Caty129/BraillePrinter/README.md

# BraillePrinter - Beta (work in progress)
- This project is based on the project of iapafoto: https://github.com/iapafoto/BraillePrinter
- Instruction videos: https://www.instructables.com/id/Cheap-Braille-Embosser-La-Picoreuse/
- OpenScad: Laser cut design https://www.thingiverse.com/thing:2841496

## Variant Arduino Uno (poplar wood)
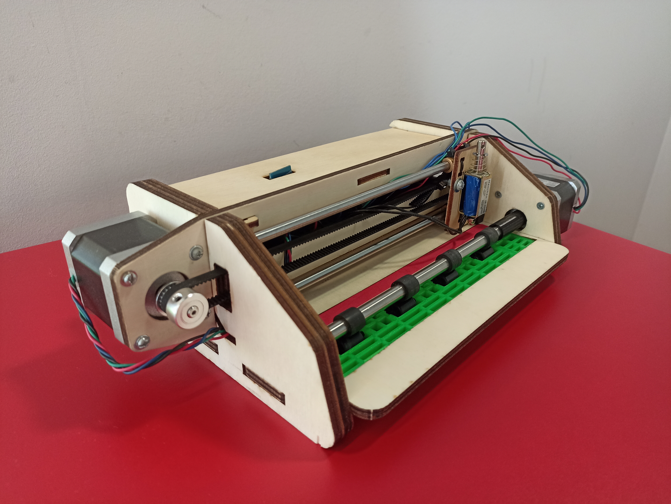
[picture p1: images/VarianteArduinoUno.jpg]


## Variant ESP32 (acrylic)
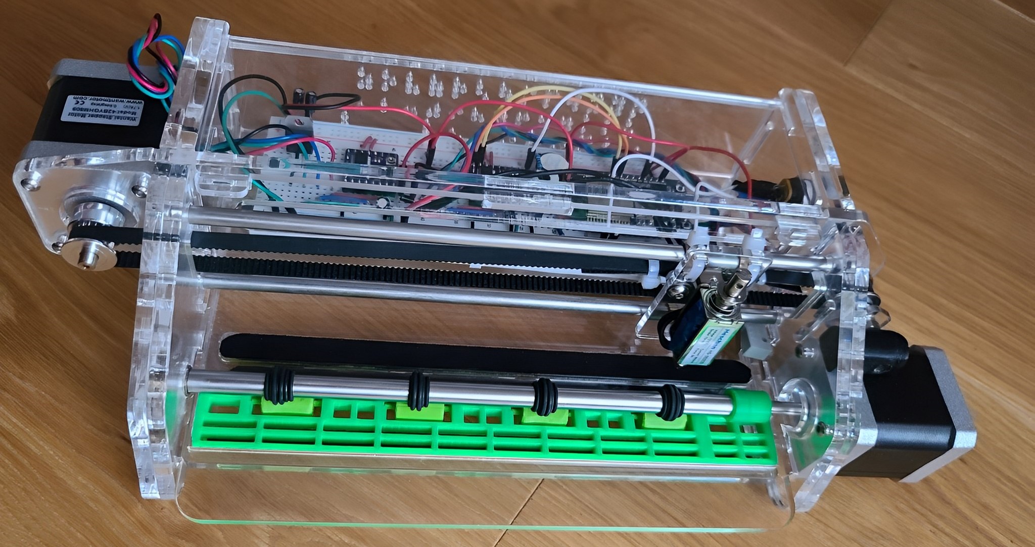
[picture p2: images/VarianteESP32.jpg]
