Caty129/BraillePrinter/Variante Arduino Uno/schematic.pdf

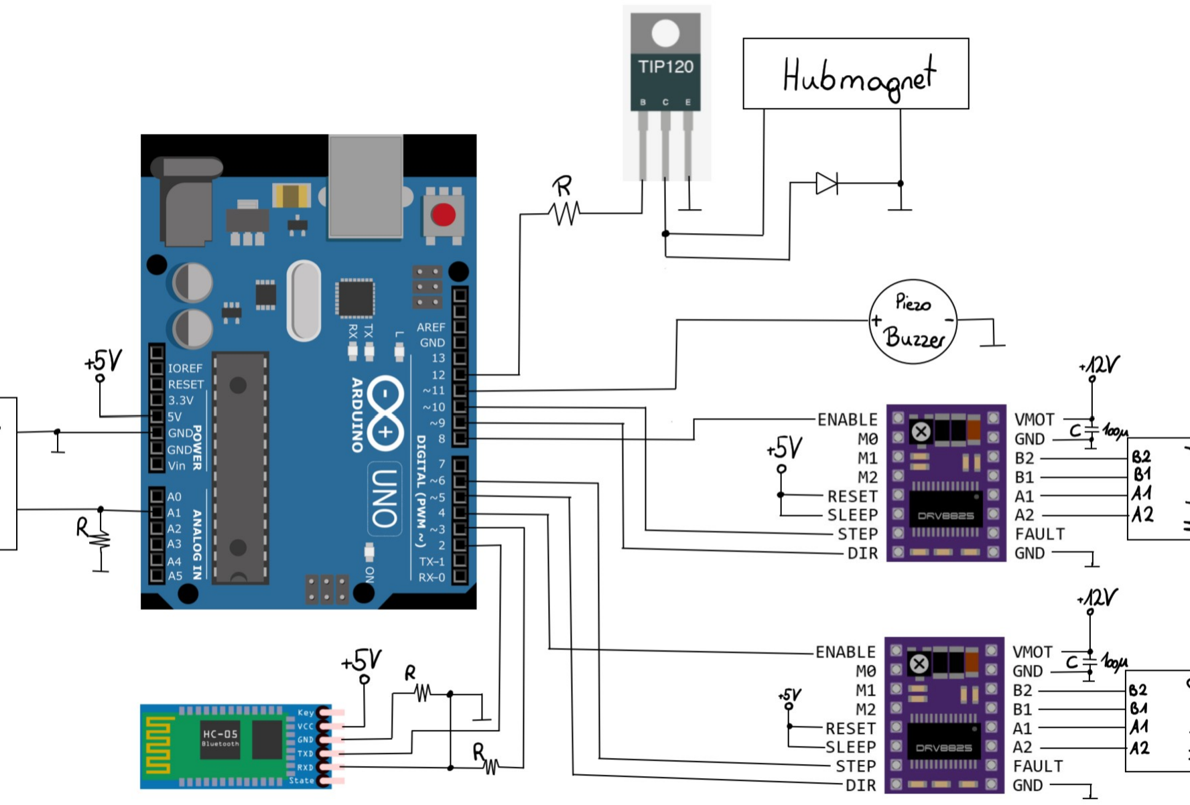
[picture p3: page 1]
