Caty129/BraillePrinter/Variante ESP32/schematic.png

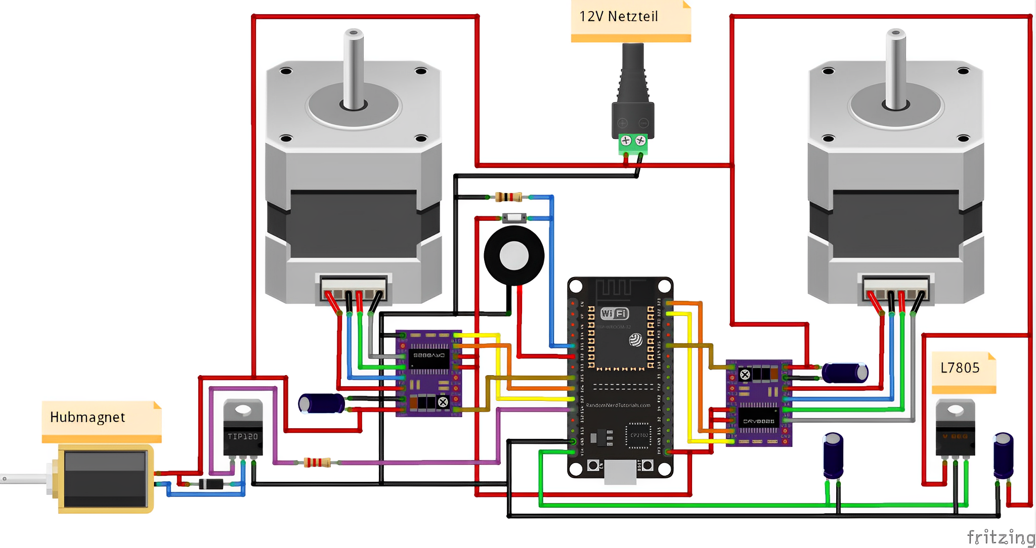
Variante ESP32/schematic.png
