Caty129/BraillePrinter/Drawings 3D Print/ShaftConnector.pdf

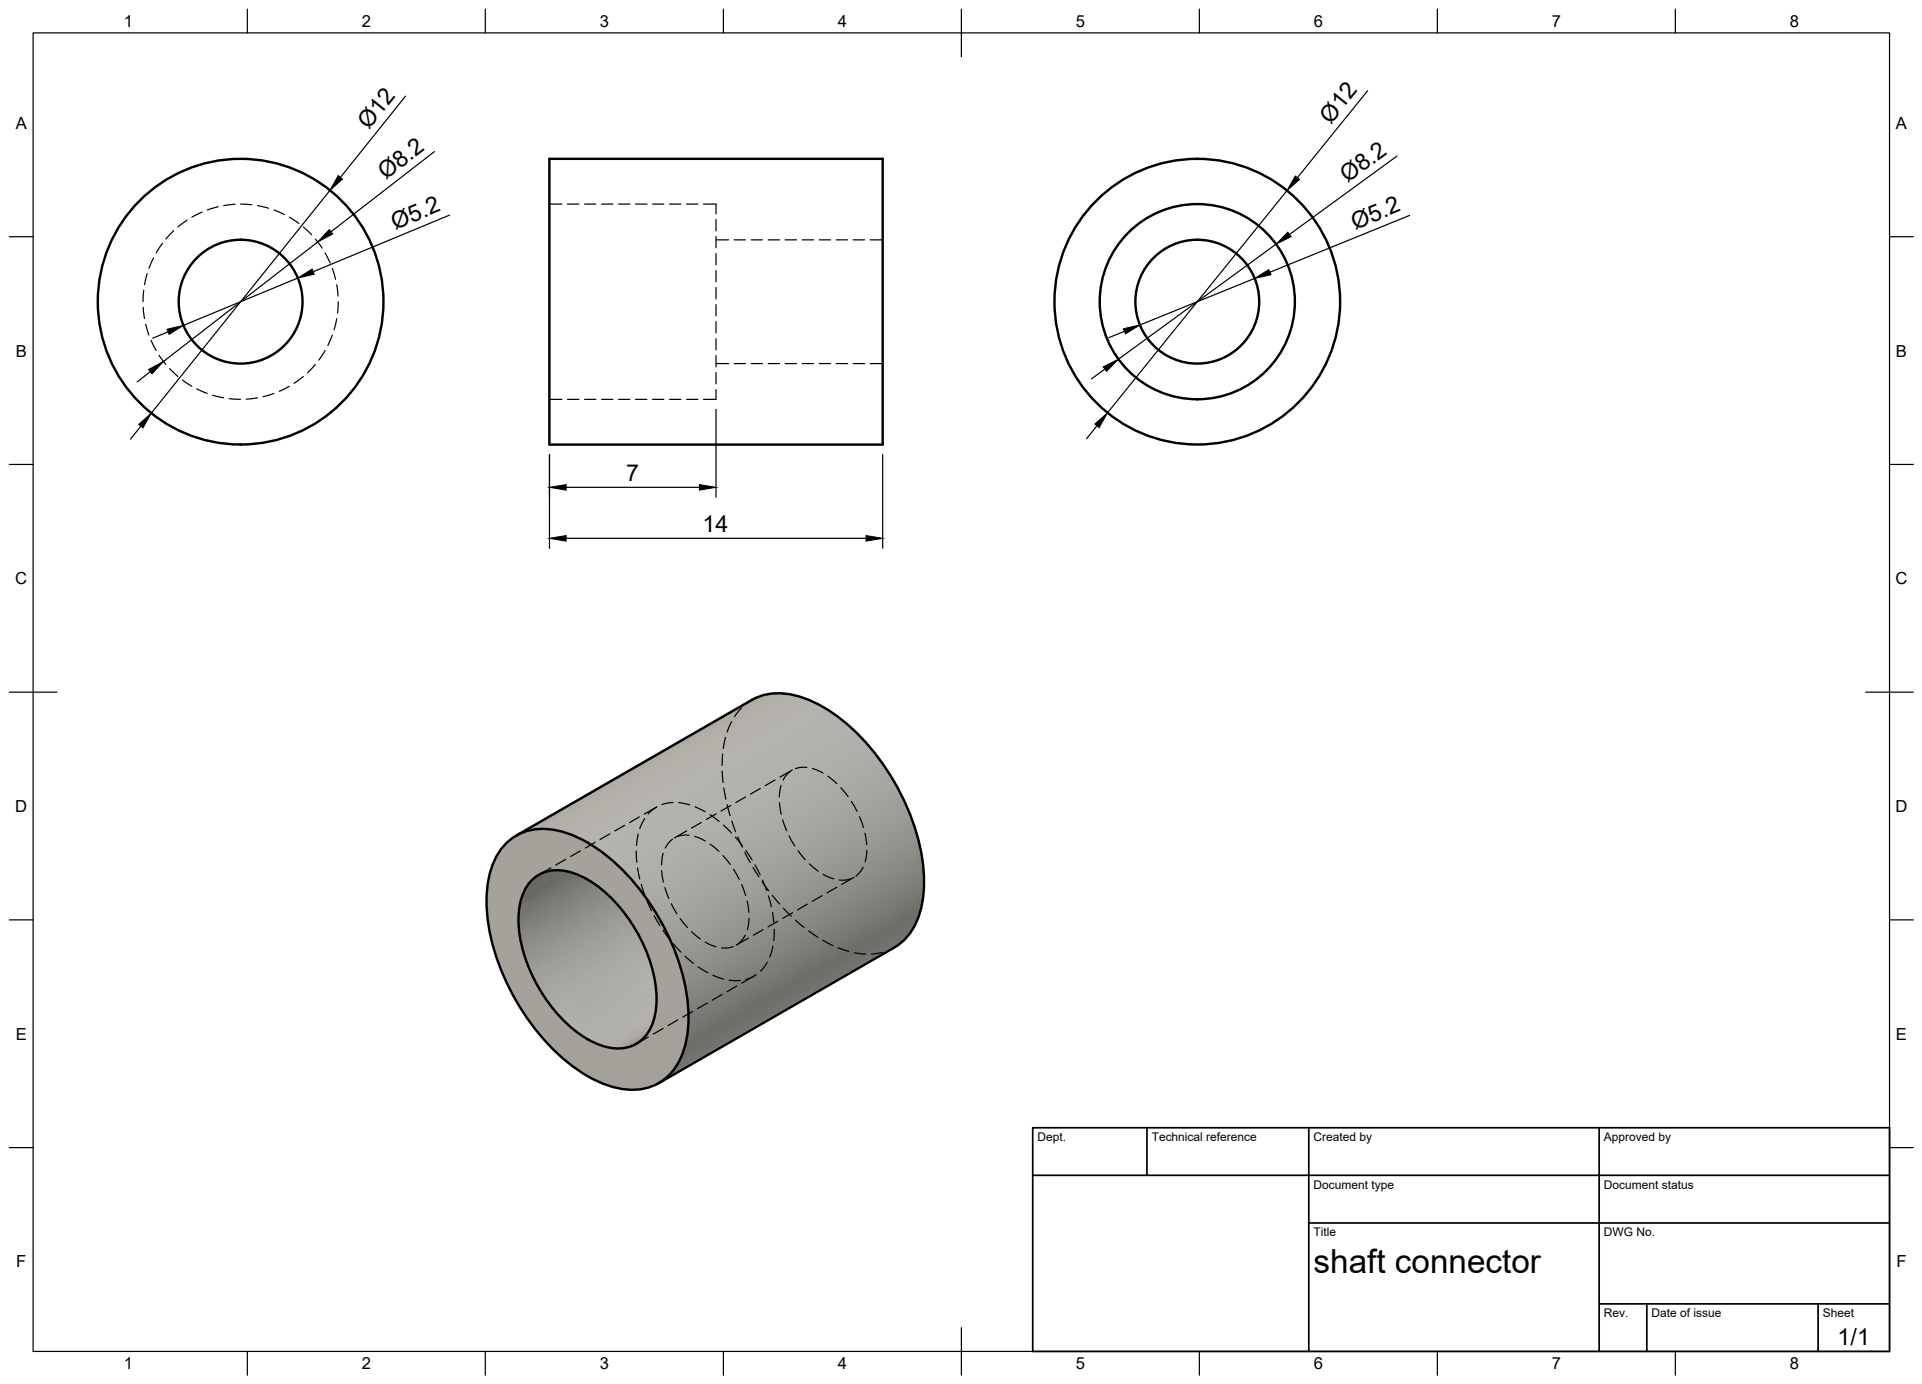
[picture p18: page 1]
Title; DWG No.; Rev.; Date of issue; Sheet; shaft connector

Dept. | Technical reference | Created by | Approved by

Document type | Document status
