Caty129/BraillePrinter/Drawings 3D Print/Belt tension.pdf

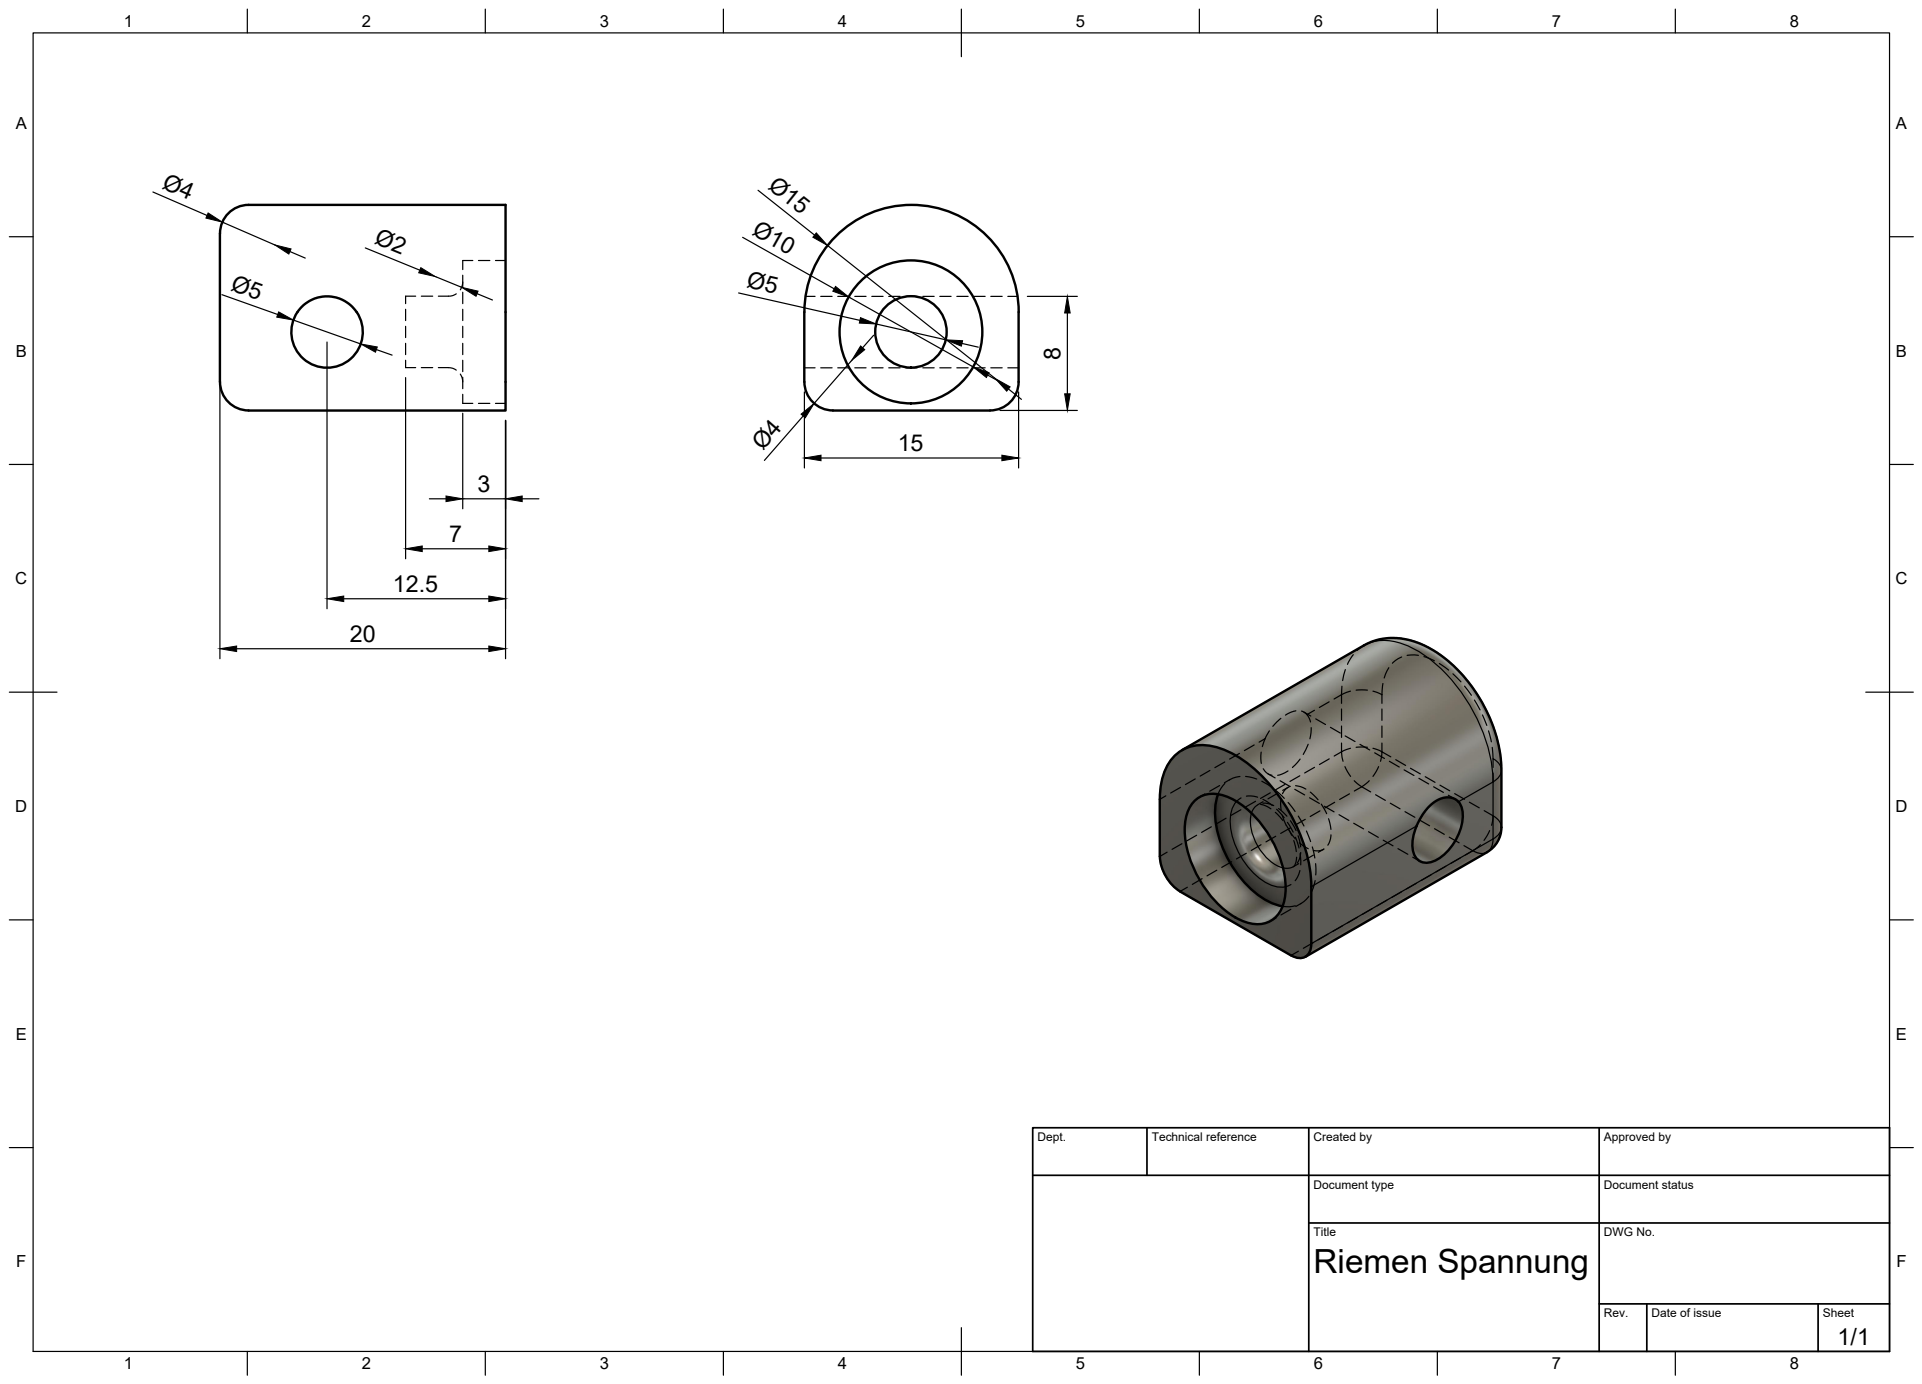
[picture p19: page 1]
Title; DWG No.; Rev.; Date of issue; Sheet; Riemen Spannung

Dept. | Technical reference | Created by | Approved by

Document type | Document status
