Caty129/BraillePrinter/Drawings 3D Print/Rolls.pdf

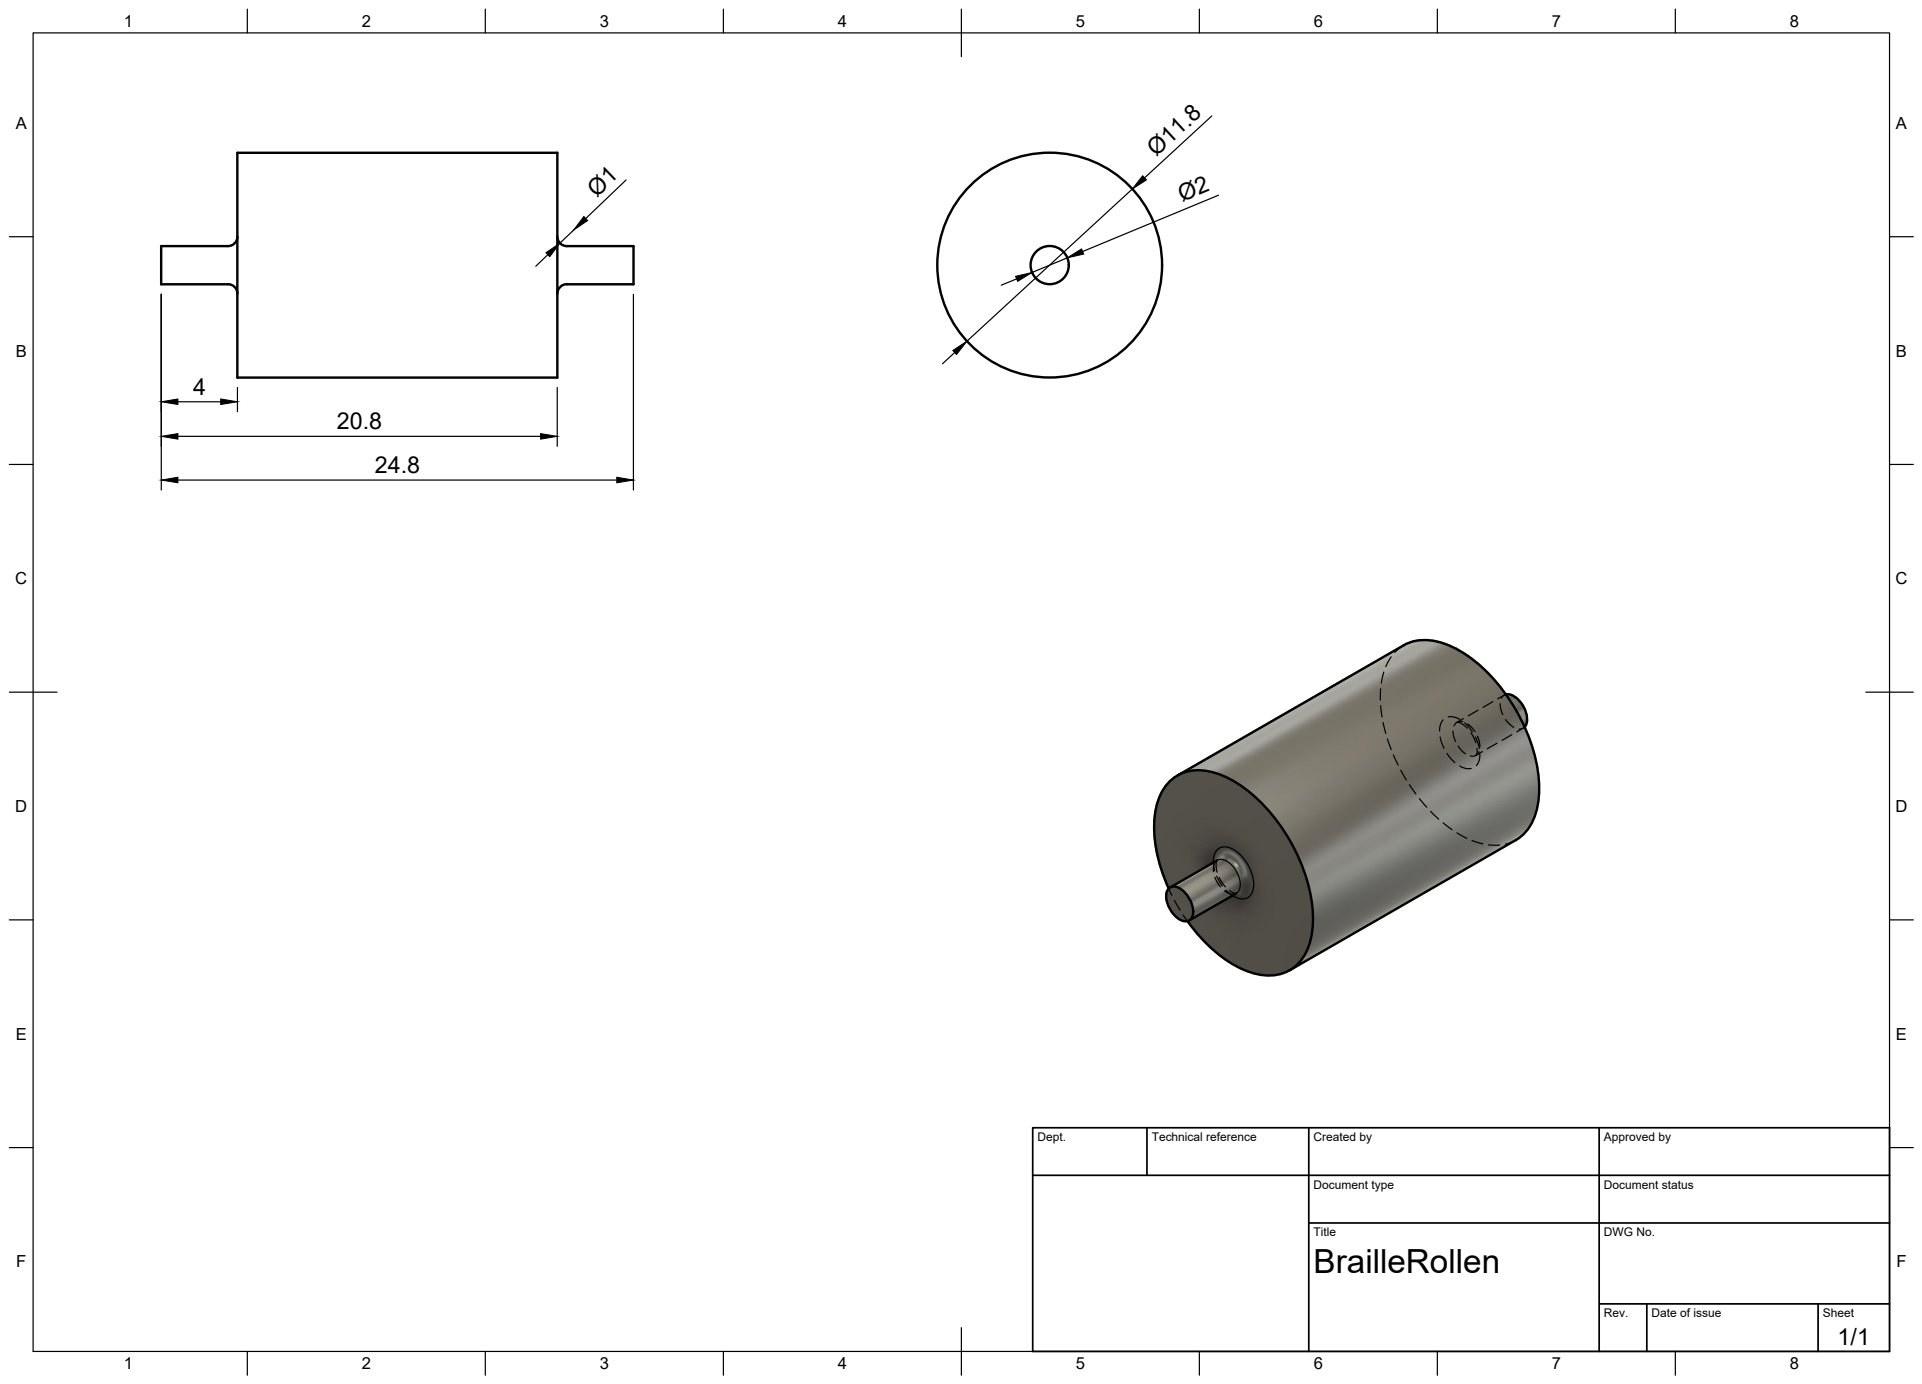
[picture p20: page 1]
Title; DWG No.; Rev.; Date of issue; Sheet

Dept. | Technical reference | Created by | Approved by

Document type | Document status
